kelu124/ultr4rick/hardware/Ultr4rick_B.png

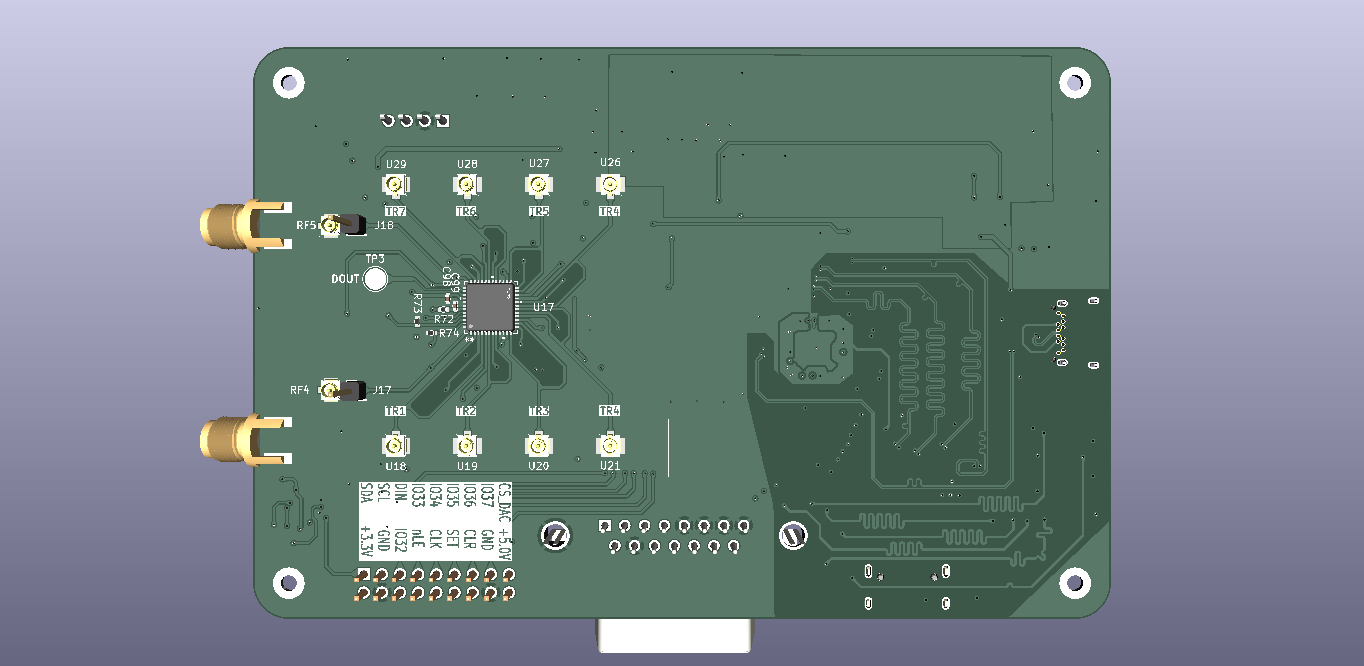
hardware/Ultr4rick_B.png
