kelu124/ultr4rick/hardware/Ultr4rick_F.png

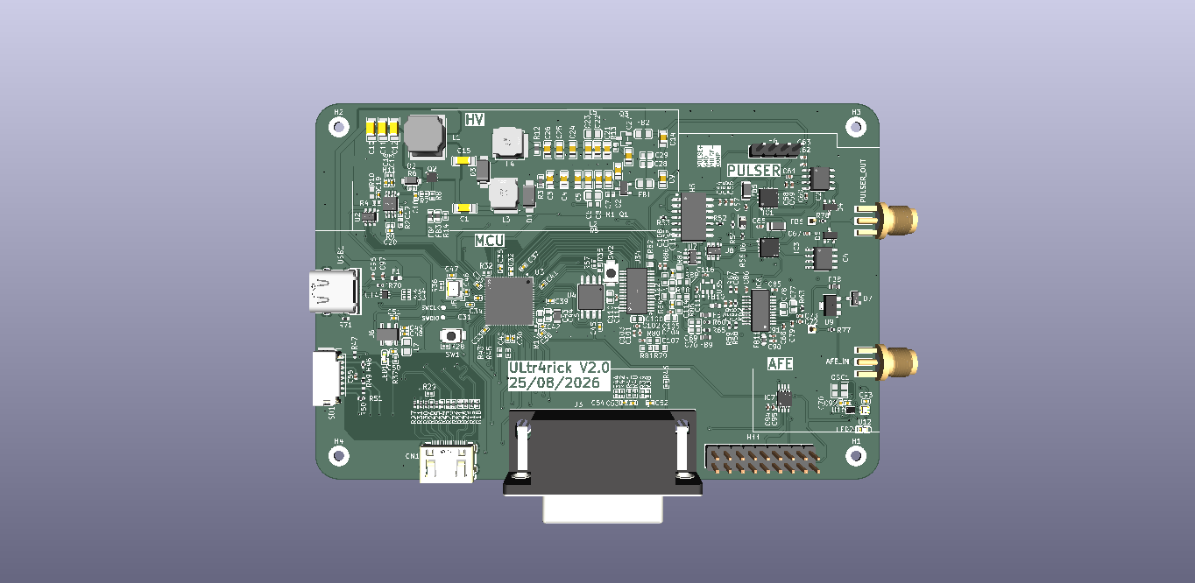
hardware/Ultr4rick_F.png
