kelu124/ultr4rick/hardware/Ultr4rick.kicad_pcb

## KiCad design hardware/Ultr4rick.kicad_pcb (2026-10-14)

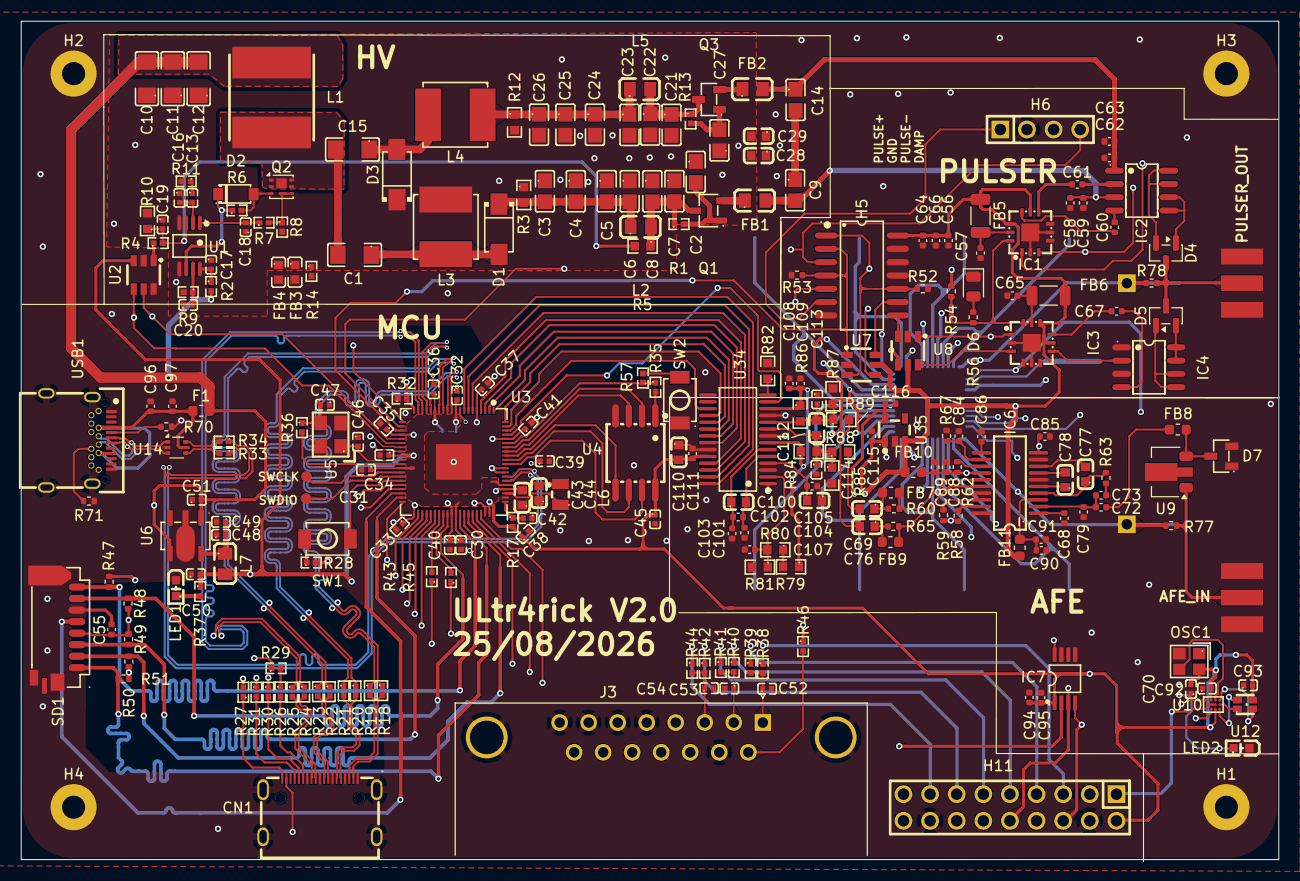
[picture p8: board Ultr4rick.kicad_pcb from above]

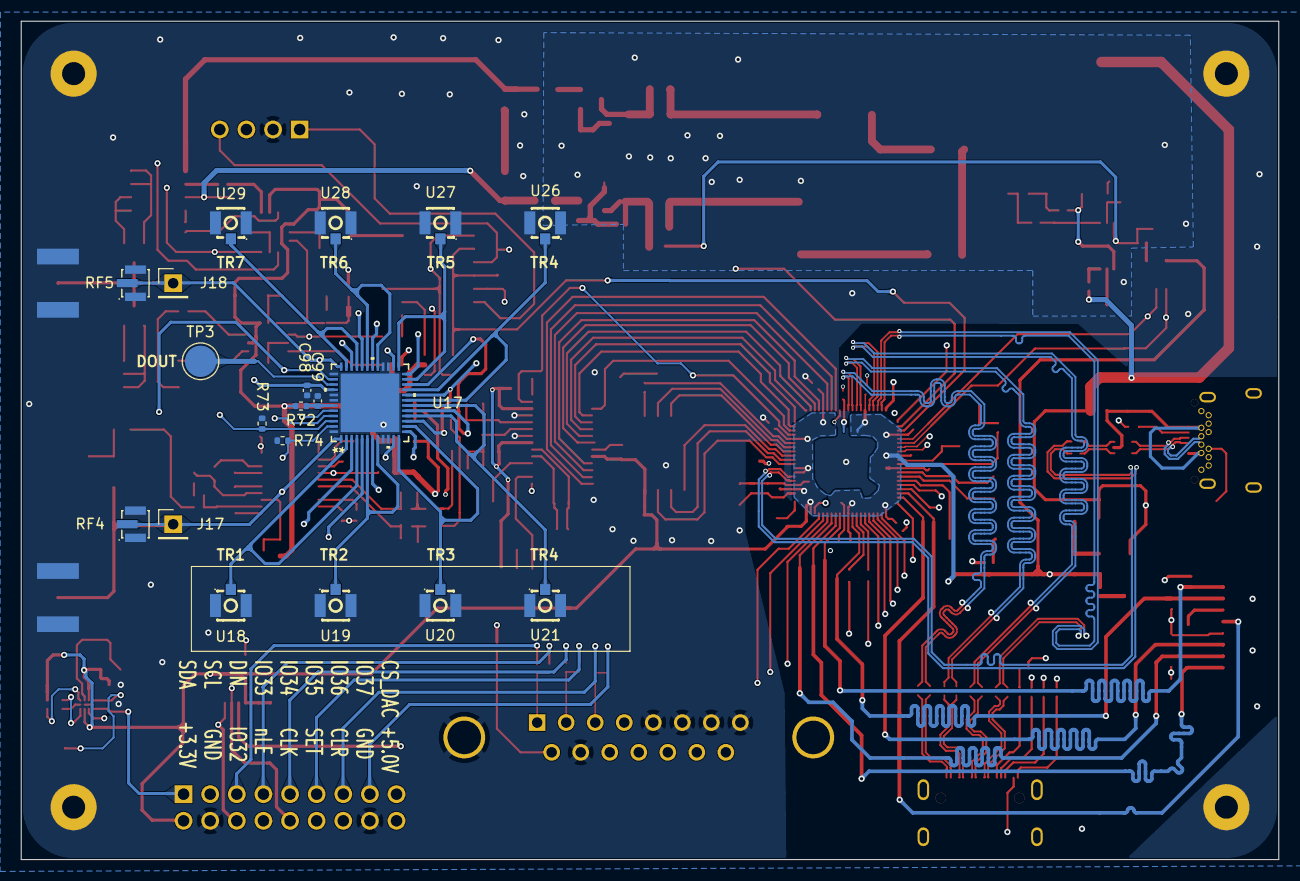
[picture p9: board Ultr4rick.kicad_pcb from below]

Board: 4 copper layers, 120.0 x 80.0 mm, 269 parts (19 on the bottom side), 198 nets.

Parts:
C1, C15: 2.2uF; C1206
C2, C3, C4, C5, C6, C7, C8, C21, C22, C23, C24, C25, C26, C27: 2.2uF; C0805
C9, C14: 100nF; C0805
C10, C11: 47uF; C1206
C12: 100nF; C1206
C13, C16, C30, C31, C33, C34, C35, C36, C37, C38, C39, C40, C41, C45, C49: 100nF; C0402
C17, C32, C42, C48: 4.7uF; C0402
C18: 2200pF; C0402
C19, C20: 100pF; C0402
C28, C29: 100nF; C0603
C43, C44: 4.7uF; C0603
C46, C47: 15pF; C0402
C50, C51: 10uF; C0402
C52, C53, C54: 220nF; C0402
C55, C94: 10uF; C_0402_1005Metric
C56, C57, C59, C63, C64, C65, C66, C68, C84, C86, C89, C91, C95, C99, C101, C102, C103, C105, C107, C109, C111: 100nF; C_0402_1005Metric
C58, C62, C98: 1uF; C_0402_1005Metric
C60, C61, C67, C72: 10nF; C_0402_1005Metric
C69, C76, C77, C78: 10nF; C0603
C70: 10nF; C0402
C73: 18nF; C_0402_1005Metric
C79: 22pF; C_0402_1005Metric
C85, C88, C90: 1nF; C_0402_1005Metric
C92, C93: 4u7; C0402
C96, C97: 4u7; C_0402_1005Metric
C100, C104, C110: 10uF; C0603
C108, C115, C116: 4.7uF; C_0402_1005Metric
C112: 100pF; C0603
C113, C114: 22pF; C0402
CN1: A71-05H4-111N1; HDMI-SMD_A71-05H4-111N1
D1, D3: SS320_C18199172; SMA_L4.3-W2.6-LS5.0-RD
D2: 1N4148W T4; SOD-123_L2.8-W1.8-LS3.7-RD
D4, D5: BAV99; SOT-23
D6: Green LED; D_0805_2012Metric
D7: BAV99-7-F; SOT-23-3_L2.9-W1.3-P1.90-LS2.4-BR
F1: 1A; Fuse_0603_1608Metric
FB1, FB2: 1.2Ω; L0805
FB3, FB4: 8.5Ω; L0603
FB5, FB6: 120Ohm 3 A; L_1206_3216Metric
FB7, FB8, FB9, FB10, FB11: L_0603_1608Metric
H1, H2, H3, H4: MountingHole_Pad; MountingHole_2.2mm_M2_Pad
H5: TC74VHC08F_EL,K,F_; SOP-14_L10.2-W5.3-P1.27-LS7.8-BL
H6: Header-Male-2.54_1x4; HDR-TH_4P-P2.54-V-M
H11: HX PZ2.54-2X9P ZZ; HDR-TH_18P-P2.54-V-M-R2-C9-S2.54-1
IC1, IC3: MD1213K6-G; QFN-12_L4.0-W4.0-P0.80-BL-EP1.7
IC2, IC4: TC6320TG-G; SOIC-8_L4.9-W3.9-P1.27-LS6.0-BL
IC6: AD8331ARQZ; QSOP-20_L8.7-W3.9-P0.64-LS6.0-BL
IC7: MCP4812-E_MS; MSOP-8_L3.0-W3.0-P0.65-LS4.9-BL
J1, J2: SMA_Edge; SMA_Edge_8mm
J3: DE15_Socket_HighDensity_MountingHoles; DSUB-15_Socket_Horizontal_P2.77x2.84mm_EdgePinOffset9.90mm_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
J17, J18: Conn_01x01_Pin; PinHeader_1x01_P2.54mm_Vertical
L1: 100uH; IND-SMD_L8.0-W8.0
L2, L5: 10uH; L0805
L3, L4: 1mH; IND-SMD_L6.0-W6.0_SWPA6045S
L6: 3.3uH; IND-SMD_L2.0-W1.6_AOTA-B201610S3R3-101-T
L7: MH2029-601Y; L0805
LED1, LED2: KT-0603R; LED-SMD_L1.6-W0.8-R-RD
NT1: NetTie_2; NetTie-2_SMD_Pad0.5mm
OSC1: SX2M32.768KM20F30TNN; OSC-SMD_4P-L2.5-W2.0-BL
Q1: FMMT495TA; SOT-23-3_L2.9-W1.6-P1.90-LS2.8-BR
Q2: CSD19538Q2; Texas_DQK
Q3: FMMT596TA; SOT-23-3_L2.9-W1.3-P1.90-LS2.4-BR
R1, R13: 10k; R0402
R2, R33, R34: 22Ω; R0402
R3, R12: 100k; R0603
R4: 56k; R0402
R5: 330k; R0603
R6: 1Ω; R0402
R7, R43, R45, R46: 100Ω; R0402
R8: 0.1Ω; R0402
R9: 40.2k; R0402
R10: 5.1k; R0603
R11: 4.7k; R0402
R14, R35: 0Ω; R0402
R17: 33Ω; R0402
R18, R19, R20, R21, R22, R23, R24, R25, R26: 200Ω; R0402
R27: 1.8kΩ; R0402
R28, R36, R57: 1kΩ; R0402
R29, R30, R31: 2.2kΩ; R0402
R32: 3.3kΩ; R0402
R37: 330Ω; R0402
R38, R40, R42: 510Ω; R0402
R39, R41, R44: 1KΩ; R0402
R47, R48, R49, R50, R51, R52, R53, R54, R58, R59, R62, R73, R74: 10K; R_0402_1005Metric
R56: 1K; R_0402_1005Metric
R60, R65: 100R; R_0402_1005Metric
R63: 280R; R_0402_1005Metric
R67: 12K; R_0402_1005Metric
R70, R71: 5K1; R_0402_1005Metric
R72: 10R; R_0402_1005Metric
R77, R78: 0Ω; R_0402_1005Metric
R79, R80, R81, R82, R84, R85, R86, R87: 1k; R0603
R88, R89: 18R; R0603
RF4, RF5: CONUFL001-SMD-T; IPEX-SMD_3P-L2.6-W2.6-LS3.0
SD1: TF-027-H300; TF-SMD_HYCW104-TF08-375B
SW1, SW2: TS-1088-AR02016; SW-SMD_L3.9-W3.0-P4.45
TP1, TP2: 1.0mm; TestPoint-1.0mm
TP3: TestPoint; TestPoint_Pad_D3.0mm
U1: LM3488MMX/NOPB; VSSOP-8_L3.0-W3.0-P0.65-LS4.9-BL
U2: MCP4725A1T-E/CH; SOT-23-6_L2.9-W1.6-P0.95-LS2.8-BR
U3: RP2350B; QFN-80_L10.0-W10.0-P0.40-TL-EP3.4
U4: W25Q128JVSIM; SOIC-8_L5.2-W5.2-P1.27-LS7.9-BL
U5: 12MHz; OSC-SMD_4P-L3.2-W2.5-BL_SIT8008BI
U6: XC6220B331PR-G; SOT-89-5_L4.5-W2.5-P1.50-LS4.4-BR
U7, U8: SN74LVC2G04DBVT; SOT-23-6_L2.9-W1.6-P0.95-LS2.8-BR
U9: MD0100N8-G; SOT-89-3
U10: LP5562TMX/NOPB; DSBGA-12_L1.7-W1.3-R3-C4-P0.40-TL
U12: A-SP1943B1GHR6C-C01-2T; LED-SMD_4P-L1.6-W1.5-BL_A-SP1943B1GHR6C-C01-2T
U14: USBLC6-2P6; SOT-666
U17: MAX14866UTM+T; 21-0144H_T4877-6_MXM
U18, U19, U20, U21, U26, U27, U28, U29: BWU.FL-IPEX1; IPEX-SMD_BWIPX-1-001E
U34: AD9215BRUZRL7-65; TSSOP-28_L9.7-W4.4-P0.65-LS6.4-BL
U35: XC6210B302MR; SOT-23-5_L2.9-W1.6-P0.95-LS2.8-BR
USB1: TYPEC-503DSL-ACP24; USB-C-SMD_TYPEC-324-BCP24

Connections:
5VLNA: C90.1, C91.1, FB11.2, IC6.3 (VPSL)
5VVGA: C88.1, C89.1, FB10.1, IC6.14 (VPOS), R58.1, R59.1, R62.1
+1.1V: C30.1, C31.1, C32.2, C44.2, L6.2, U3.10 (DVDD), U3.32 (DVDD), U3.51 (DVDD), U3.65 (VREG_FB)
+3.3V: C33.1, C34.1, C35.1, C36.1, C37.1, C38.1, C39.1, C40.1, C41.1, C43.2, C45.1, C50.2, C55.2, C70.2, C92.2, C93.2, C94.1, C95.1, C98.2, C110.2, C111.1, H11.2, IC7.1 (VDD), L7.2, OSC1.4 (VDD), R17.2, R37.1, R47.1, R48.1, R49.1, R50.1, R51.1, R54.1, SD1.4 (VDD), U2.3 (VDD), U3.5 (IOVDD), U3.15 (IOVDD), U3.24 (IOVDD), U3.29 (IOVDD), U3.41 (IOVDD), U3.50 (IOVDD), U3.59 (ADC_AVDD), U3.60 (IOVDD), U3.64 (VREG_VIN), U3.68 (USB_OTP_VDD), U3.69 (QSPI_IOVDD), U3.76 (IOVDD), U4.8 (VCC), U10.A2 (VDD), U10.C3 (EN/VCC), U12.3, U17.40 (VDD), U34.24 (DRVDD)
+5V: C10.2, C11.2, C12.2, C51.2, C56.1, C64.1, C66.1, C115.1, CN1.18 (+5V), F1.2, FB5.1, FB6.1, FB10.2, FB11.1, H5.14 (VCC), H11.18, IC1.8 (VH), IC1.10 (VDD2), IC3.8 (VH), IC3.10 (VDD2), L1.1 (+), R2.2, R46.1, R72.2, U6.1 (CE), U6.4 (VIN), U7.5 (VCC), U8.5 (VCC), U35.1 (VIN), U35.3 (CE)
+HV: C9.2, C58.2, C59.2, FB1.2, IC2.3 (SP)
-HV: C14.1, C62.2, C63.2, FB2.2, IC2.1 (SN)
/DAC+AFE/ECHO_IN: J2.1 (In), R77.2, U9.1 (A)
/MUX/DOUT: TP3.1 (1_1), U17.39 (DOUT)
/MUX/MUX_IN: J17.1 (Pin_1_1), R77.1, RF4.1, U17.1 (COM0), U17.5 (COM2), U17.11 (COM4), U17.15 (COM6), U17.20 (COM8), U17.24 (COM10), U17.30 (COM12), U17.34 (COM14)
/MUX/MUX_OUT: J18.1 (Pin_1_1), R78.1, RF5.1, U17.3 (COM1), U17.7 (COM3), U17.13 (COM5), U17.17 (COM7), U17.22 (COM9), U17.26 (COM11), U17.32 (COM13), U17.36 (COM15)
/MUX/NO0: U17.2 (NO0), U17.4 (NO1), U18.1
/MUX/NO2: U17.6 (NO2), U17.8 (NO3), U19.1
/MUX/NO4: U17.12 (NO4), U17.14 (NO5), U20.1
/MUX/NO6: U17.16 (NO6), U17.18 (NO7), U21.1
/MUX/NO8: U17.19 (NO8), U17.21 (NO9), U26.1
/MUX/NO10: U17.23 (NO10), U17.25 (NO11), U27.1
/MUX/NO12: U17.29 (NO12), U17.31 (NO13), U28.1
/MUX/NO14: U17.33 (NO14), U17.35 (NO15), U29.1
/MUX/TX: D4.3 (K), D5.3 (K), J1.1 (In), R78.2
/RP2350B/BLUE: C54.1, J3.3, R42.2, R44.2
/RP2350B/BOOT: SW1.1, U3.35 (RUN)
/RP2350B/GREEN: C53.1, J3.2, R40.2, R41.2
/RP2350B/HDMI_CLK_N: CN1.12 (TMDS_CLOCK-), R25.2
/RP2350B/HDMI_CLK_P: CN1.11 (TMDS_CLOCK+), R24.2
/RP2350B/HDMI_D0_N: CN1.9 (TMDS_DATA0-), R23.2
/RP2350B/HDMI_D0_P: CN1.8 (TMDS_DATA0+), R22.2
/RP2350B/HDMI_D1_N: CN1.6 (TMDS_DATA1-), R21.2
/RP2350B/HDMI_D1_P: CN1.5 (TMDS_DATA1+), R20.2
/RP2350B/HDMI_D2_N: CN1.3 (TMDS_DATA2-), R19.2
/RP2350B/HDMI_D2_P: CN1.2 (TMDS_DATA2+), R18.2
/RP2350B/RED: C52.1, J3.1, R38.2, R39.2
/RP2350B/SWCLK: TP1.1 (1_1), U3.33 (SWCLK)
/RP2350B/SWDIO: TP2.1 (1_1), U3.34 (SWDIO)
/RP2350B/USB_DN: R33.1, U3.66 (USB_DM)
/RP2350B/USB_DP: R34.1, U3.67 (USB_DP)
/SEPIC_HV/Vfb: C19.2, R4.2, R5.2, R10.1, U1.3 (FB)
/USB3/USB_DDN: R33.2, U14.4 (IO2)
/USB3/USB_DDP: R34.2, U14.6 (IO1)
/USB3/VBUS: C96.2, C97.1, F1.1, U14.5 (VBUS), USB1.A4 (VBUS), USB1.A9 (VBUS), USB1.B4 (VBUS), USB1.B9 (VBUS)
ADC_0: U3.78 (GPIO1), U34.17 (D0(LSB))
ADC_1: U3.79 (GPIO2), U34.18 (D1)
ADC_2: U3.80 (GPIO3), U34.19 (D2)
ADC_3: U3.1 (GPIO4), U34.20 (D3)
ADC_4: U3.2 (GPIO5), U34.21 (D4)
ADC_5: U3.3 (GPIO6), U34.22 (D5)
ADC_6: U3.4 (GPIO7), U34.25 (D6)
ADC_7: U3.6 (GPIO8), U34.26 (D7)
ADC_8: U3.7 (GPIO9), U34.27 (D8)
ADC_9: U3.8 (GPIO10), U34.28 (D9(MSB))
ADC_CLK: U3.77 (GPIO0), U34.13 (CLK)
AVDD: C108.1, C109.1, C116.1, R79.1, R84.1, R86.1, U34.7 (AVDD), U34.12 (AVDD), U35.5 (OUT)
AVSS: C9.1, C14.2
B: U10.A4 (B), U12.4
CLK: H11.10, IC7.3 (SCK), U3.27 (GPIO26), U17.45 (CLK)
CLK_N: R25.1, U3.19 (GPIO19)
CLK_P: R24.1, U3.18 (GPIO18)
CLR: H11.14, R74.1, U3.37 (GPIO29), U17.47 (CLR)
CS_DAC: H11.17, IC7.2 (~CS), U3.9 (GPIO11)
DAC_G: C85.1, IC6.10 (GAIN), IC7.8 (VOUTA)
DAMP: H5.3 (1Y), H6.4, IC3.1 (INA), U8.1 (1A)
DIN: H11.6, IC7.4 (SDI), U3.28 (GPIO27), U17.44 (DIN)
DVI_CEC: R29.1, U3.57 (GPIO46_ADC6)
DVI_D0_N: R23.1, U3.17 (GPIO17)
DVI_D0_P: R22.1, U3.16 (GPIO16)
DVI_D1_N: R21.1, U3.14 (GPIO15)
DVI_D1_P: R20.1, U3.13 (GPIO14)
DVI_D2_N: R19.1, U3.12 (GPIO13)
DVI_D2_P: R18.1, U3.11 (GPIO12)
DVI_SCL: R30.1, U3.56 (GPIO45_ADC5)
DVI_SDA: R31.1, U3.55 (GPIO44_ADC4)
G: U10.B4 (G), U12.1
GND: C28.1, C29.1, C30.2, C31.2, C32.1, C33.2, C34.2, C35.2, C36.2, C37.2, C38.2, C39.2, C40.2, C41.2, C42.1, C43.1, C44.1, C45.2, C46.1, C47.1, C48.1, C49.2, C50.1, C51.1, C52.2, C53.2, C54.2, C55.1, C56.2, C57.1, C58.1, C59.1, C62.1, C63.1, C64.2, C65.1, C66.2, C68.1, C70.1, C79.2, C84.2, C85.2, C86.2, C88.2, C89.2, C90.2, C91.2, C92.1, C93.1, C94.2, C95.2, C96.1, C97.2, C98.1, C99.1, C101.1, C103.1, C104.1, C105.2, C107.2, C108.2, C109.2, C110.1, C111.2, C113.1, C114.2, C115.2, C116.2, CN1.1 (TMDS_DATA2_SHIELD), CN1.4 (TMDS_DATA1_SHIELD), CN1.7 (TMDS_DATA0_SHIELD), CN1.10 (TMDS_CLOCK_SHIELD), CN1.13 (DDC/CEC_GND), CN1.20 (SHELL), CN1.21 (SHELL), CN1.22 (SHELL), CN1.23 (SHELL), D6.1, D7.1, D7.2, FB3.2, FB4.2, H1.1 (1_1), H2.1 (1_1), H3.1 (1_1), H4.1 (1_1), H5.7 (GND), H5.11 (4Y), H5.12 (4A), H5.13 (4B), H6.2, H11.4, H11.16, IC1.2 (VL), IC1.4 (GND_1), IC1.5 (VSS1), IC1.6 (VSS2), IC1.13 (GND_2), IC3.2 (VL), IC3.4 (GND_1), IC3.5 (VSS1), IC3.6 (VSS2), IC3.13 (GND_2), IC4.1 (SN), IC4.3 (SP), IC6.6 (COML), IC6.9 (MODE), IC6.17 (COMM_1), IC6.20 (COMM_2), IC7.5 (~LDAC), IC7.7 (VSS), J1.2 (Ext), J2.2 (Ext), J3.5, J3.6, J3.7, J3.8, J3.10, J3.SH, LED1.2 (K), LED2.2 (K), OSC1.2 (GND), R14.2, R28.2, R32.1, R52.2, R53.2, R67.2, R70.1, R71.2, R73.2, R74.2, R81.2, R82.2, R85.2, R87.2, RF4.2, RF4.3, RF5.2, RF5.3, SD1.6 (VSS), SD1.10, SD1.11, SW2.2, U2.2 (VSS), U2.6 (A0), U3.62 (VREG_PGND), U3.81 (GND), U4.4 (GND), U5.2 (GND), U5.4 (GND), U6.2 (VSS), U7.2 (GND), U8.2 (GND), U10.B1 (ADDR_SEL1), U10.B2 (ADDR_SEL0), U10.B3 (GND), U14.2 (GND), U17.9 (GND), U17.10 (GND), U17.27 (GND), U17.28 (GND), U17.37 (GND), U17.41 (GND), U17.42 (GND), U17.48 (GND), U17.49 (EPAD), U18.2, U18.3, U19.2, U19.3, U20.2, U20.3, U21.2, U21.3, U26.2, U26.3, U27.2, U27.3, U28.2, U28.3, U29.2, U29.3, U34.3 (SENSE), U34.8 (AGND), U34.11 (AGND), U34.23 (DRGND), U35.2 (GND), USB1.1 (EH), USB1.2 (EH), USB1.3 (EH), USB1.4 (EH), USB1.A1 (GND), USB1.A12 (GND), USB1.B1 (GND), USB1.B12 (GND)
GPIO20: R27.2, R32.2, U3.20 (GPIO20)
GPIO32: H11.5, R38.1, U3.40 (GPIO32)
GPIO33: H11.7, R39.1, U3.42 (GPIO33)
GPIO34: H11.9, R40.1, U3.43 (GPIO34)
GPIO35: H11.11, R41.1, U3.44 (GPIO35)
GPIO36: H11.13, R42.1, U3.45 (GPIO36)
GPIO37: H11.15, R44.1, U3.46 (GPIO37)
GPIO38: R43.2, U3.47 (GPIO38)
GPIO39: R45.2, U3.48 (GPIO39)
HVGND: C2.1, C3.1, C4.1, C5.1, C6.1, C7.1, C8.1, C10.1, C11.1, C12.1, C16.1, C17.1, C18.1, C19.1, C20.1, C21.2, C22.2, C23.2, C24.2, C25.2, C26.2, C27.1, C28.2, C29.2, D3.1 (K), FB3.1, FB4.1, L3.1 (+), R3.1, R8.2, R9.2, R10.2, R11.2, R12.2, R14.1, U1.4 (AGND), U1.5 (PGND)
I2C0_SCL: H11.3, U2.4 (SDA), U3.26 (GPIO25), U10.C2 (SCL)
I2C0_SDA: H11.1, U2.5 (SCL), U3.25 (GPIO24), U10.C1 (SDA)
INPUT_A: H5.1 (1A), H5.10 (3B), R52.1, U3.22 (GPIO22), U7.3 (2A)
INPUT_B: H5.2 (1B), H5.4 (2A), R53.1, U3.23 (GPIO23), U7.1 (1A)
unnamed: C13.1, R11.1
unnamed: C47.2, R36.1, U5.3
unnamed: C69.1, FB7.2, R60.2
unnamed: C72.1, FB8.2
unnamed: C73.2, R63.1
unnamed: C76.1, FB9.2, R65.2
unnamed: CN1.14 (CEC), R26.2
unnamed: CN1.19 (HP_DETECT), R27.1
unnamed: CN1.15 (SCL), R30.2
unnamed: CN1.16 (SDA), R31.2
unnamed: C1.1, D1.2 (A), L3.2 (-)
unnamed: C3.2, C4.2, C5.2, C6.2, D1.1 (K), L2.1 (+), R3.2
unnamed: D2.2 (A), Q2.3 (G), R6.2
unnamed: D2.1 (K), R6.1, U1.6 (DR)
unnamed: C15.1, D3.2 (A), L4.2 (-)
unnamed: D4.2 (A), IC2.7 (DN_1), IC2.8 (DN_2)
unnamed: D5.2 (A), IC4.7 (DN_1), IC4.8 (DN_2)
unnamed: D6.2, R56.2
unnamed: H5.5 (2B), U7.4 (2Y)
unnamed: H5.9 (3A), U7.6 (1Y)
unnamed: H5.8 (3Y), U8.3 (2A)
unnamed: C60.1, IC1.9 (OUTA)
unnamed: C61.1, IC1.7 (OUTB)
unnamed: C57.2, FB5.2, IC1.11 (VDD1)
unnamed: D4.1 (K), IC2.5 (DP_1), IC2.6 (DP_2)
unnamed: C61.2, IC2.2 (GN)
unnamed: C60.2, IC2.4 (GP)
unnamed: C67.1, IC3.9 (OUTA)
unnamed: IC3.7 (OUTB), IC4.2 (GN)
unnamed: C65.2, FB6.2, IC3.11 (VDD1)
unnamed: D5.1 (K), IC4.5 (DP_1), IC4.6 (DP_2)
unnamed: C67.2, IC4.4 (GP)
unnamed: IC6.19 (ENBL), R58.2
unnamed: IC6.18 (ENBV), R59.2
unnamed: IC6.13 (HILO), R62.2
unnamed: C72.2, C73.1, C79.1, IC6.2 (INH)
unnamed: C68.2, IC6.1 (LMD)
unnamed: C77.1, IC6.4 (LON), R63.2
unnamed: C78.1, IC6.5 (LOP)
unnamed: C84.1, IC6.12 (RCLMP), R67.1
unnamed: C86.1, IC6.11 (VCM)
unnamed: C77.2, IC6.8 (VIN)
unnamed: C78.2, IC6.7 (VIP)
unnamed: J3.9, R46.2
unnamed: J3.13, R43.1
unnamed: J3.14, R45.1
unnamed: C1.2, C15.2, L1.2 (-), Q2.1 (D), Q2.2 (D), Q2.5 (D), Q2.6 (D), Q2.8 (D)
unnamed: C7.2, C8.2, L2.2 (-), Q1.3 (C), R1.1, R5.1
unnamed: C23.1, C24.1, C25.1, C26.1, L4.1 (+), L5.1 (+), R12.1
unnamed: C21.1, C22.1, L5.2 (-), Q3.3 (C), R13.1
unnamed: LED1.1 (A), R37.2
unnamed: LED2.1 (A), U10.A1 (W)
unnamed: OSC1.3 (OUTPUT), U10.A3 (CLK_32K)
unnamed: C2.2, Q1.1 (B), R1.2
unnamed: FB1.1, Q1.2 (E)
unnamed: Q2.4 (S), Q2.7 (S), R7.2, R8.1
unnamed: C27.2, Q3.1 (B), R13.2
unnamed: FB2.1, Q3.2 (E)
unnamed: R26.1, R29.2
unnamed: R28.1, SW1.2
unnamed: R57.2, SW2.1
unnamed: R79.2, R80.1
unnamed: C13.2, C16.2, U1.2 (COMP)
unnamed: C20.2, R9.1, U1.7 (FA)
unnamed: C18.2, R7.1, U1.1 (ISEN)
unnamed: C17.2, R2.1, U1.8 (VIN)
unnamed: C42.2, R17.1, U3.61 (VREG_AVDD)
unnamed: L6.1, U3.63 (VREG_LX)
unnamed: R35.2, U4.1 (/CS)
unnamed: C48.2, C49.1, L7.1, U6.5 (VOUT)
unnamed: D7.3, FB8.1, U9.3 (B)
unnamed: C99.2, R72.1, U17.43 (VCC)
unnamed: C107.1, R80.2, R81.1, U34.2 (MODE)
unnamed: R82.1, U34.14 (PDWN)
unnamed: C100.2, C101.2, C102.1, U34.5 (REFB)
unnamed: C100.1, C102.2, C103.2, U34.6 (REFT)
unnamed: C112.1, C114.1, R84.2, R85.1, R88.1, U34.9 (VIN+)
unnamed: C112.2, C113.2, R86.2, R87.1, R89.1, U34.10 (VIN–)
unnamed: C104.2, C105.1, U34.4 (VREF)
unnamed: R70.2, USB1.A5 (CC1)
unnamed: R71.1, USB1.B5 (CC2)
OE: IC1.12 (OE), IC3.12 (OE), NT1.2, R56.1
OE_HV: NT1.1, R54.2
OR: U3.58 (GPIO47_ADC7), U34.1 (OR)
PULSE+: H5.6 (2Y), H6.1, IC1.1 (INA)
PULSE-: H6.3, IC1.3 (INB), U8.4 (2Y)
QSPI_SCLK: U3.71 (QSPI_SCLK), U4.6 (CLK)
QSPI_SD0: U3.72 (QSPI_SD0), U4.5 (DI(IO0))
QSPI_SD1: U3.74 (QSPI_SD1), U4.2 (DO(IO1))
QSPI_SD2: U3.73 (QSPI_SD2), U4.3 (/WP(IO2))
QSPI_SD3: U3.70 (QSPI_SD3), U4.7 (/HOLDor/RESET(IO3))
QSPI_SS: R35.1, R57.1, U3.75 (QSPI_SS)
R: U10.C4 (R), U12.2
SD_CMD: R49.2, SD1.3 (CMD), U3.39 (GPIO31)
SD_D0: R48.2, SD1.7 (DAT0), U3.49 (GPIO40_ADC0)
SD_D1: R47.2, SD1.8 (DAT1), U3.52 (GPIO41_ADC1)
SD_D2: R51.2, SD1.1 (DAT2), U3.53 (GPIO42_ADC2)
SD_D3: R50.2, SD1.2 (CD/DAT3), U3.54 (GPIO43_ADC3)
SD_SCK: SD1.5 (CLK), U3.38 (GPIO30)
SET: H11.12, R73.1, U3.36 (GPIO28), U17.46 (SET)
TO_ADC_H: C69.2, R88.2
TO_ADC_L: C76.2, R89.2
UD+: U14.1 (IO1), USB1.A6 (DP1), USB1.B6 (DP2)
UD-: U14.3 (IO2), USB1.A7 (DN1), USB1.B7 (DN2)
VOH: FB7.1, IC6.15 (VOH), R60.1
VOL: FB9.1, IC6.16 (VOL), R65.1
Vadj: R4.1, U2.1 (VOUT)
XIN: C46.2, U3.30 (XIN), U5.1
XOUT: R36.2, U3.31 (XOUT)
nLE: H11.8, U3.21 (GPIO21), U17.38 (*LE)
~DAMP: IC3.3 (INB), U8.6 (1Y)
