kelu124/ultr4rick/firmware/hw/u4rk.h

// SPDX-License-Identifier: GPL-3.0-or-later
#ifndef U4RK_H
#define U4RK_H

#include <stdbool.h>
#include <stddef.h>
#include <stdint.h>

/* Sample counts are mode-dependent, not build-dependent:
 *   - FFT/envelope path (read_fft) is fixed at 4096, the max power-of-two the
 *     CMSIS arm_rfft_fast_f32 supports.
 *   - Raw path (read_raw) captures 8000 (matches the historical mainline depth).
 * Buffers are sized to U4RK_MAX_SAMPLE_COUNT. */
#define U4RK_SAMPLE_COUNT             4096u   /* FFT/envelope length */
#define U4RK_RAW_SAMPLE_COUNT         8000u   /* raw-only length */
#define U4RK_MAX_SAMPLE_COUNT         U4RK_RAW_SAMPLE_COUNT
#define U4RK_SAMPLE_RATE_HZ           60000000u
#define U4RK_PROTOCOL_VERSION         1u
#define U4RK_HEADER_SIZE              64u
/* Largest payload across modes: 4096 floats (16384 B) > 8000 u16 (16000 B). */
#define U4RK_MAX_PAYLOAD_SIZE         (U4RK_SAMPLE_COUNT * sizeof(float))
#define U4RK_MAX_FRAME_SIZE           (U4RK_HEADER_SIZE + U4RK_MAX_PAYLOAD_SIZE)
#define U4RK_RAW_BUFFER_COUNT         2u
#define U4RK_OUTPUT_SLOT_COUNT        2u
#define U4RK_ALAW_DEFAULT_REFERENCE   512.0f
#define U4RK_RAW_MAX_RATE_HZ          100u
#define U4RK_ENVELOPE_MAX_RATE_HZ     50u
#define U4RK_ALAW_MAX_RATE_HZ         70u
#define U4RK_DSP_TARGET_US            4500u

/* Pin map: Ultr4rick v2 (hardware/) on RP2350B. See PINMAP.md. */
#define U4RK_ADC_CLOCK_PIN            0u
#define U4RK_ADC_DATA_FIRST_PIN       1u
#define U4RK_ADC_DATA_PIN_COUNT       10u

/* Pulser A/B on consecutive pins (A = bit 0, B = bit 1):
 *   B A = 0 0 all low, 0 1 negative, 1 1 damping, 1 0 positive. */
#define U4RK_PULSER_PIN_BASE          22u
#define U4RK_PULSER_A_PIN             22u
#define U4RK_PULSER_B_PIN             23u
#define U4RK_PULSER_STATE_OFF         0u
#define U4RK_PULSER_STATE_NEGATIVE    1u
#define U4RK_PULSER_STATE_POSITIVE    2u
#define U4RK_PULSER_STATE_DAMP        3u

/* SPI1 bus shared by the MCP4812 (CS_DAC) and MAX14866 (nLE). */
#define U4RK_SPI_SCK_PIN              26u
#define U4RK_SPI_TX_PIN               27u
#define U4RK_DAC_CS_PIN               11u

#define U4RK_MUX_LE_PIN               21u
#define U4RK_MUX_SET_PIN              28u
#define U4RK_MUX_CLR_PIN              29u

/* I2C0: LP5562 RGB status LED (hw/led.c), MCP4725 (unused). */
#define U4RK_I2C_SDA_PIN              24u
#define U4RK_I2C_SCL_PIN              25u
#define U4RK_LED_LEVEL_PERCENT        5u    /* status LED brightness, % of full PWM */

/* uSD (4-bit SDIO): D0..D3 consecutive. Not driven by the firmware yet. */
#define U4RK_SD_SCK_PIN               30u
#define U4RK_SD_CMD_PIN               31u
#define U4RK_SD_D0_PIN                40u
#define U4RK_SD_DATA_PIN_COUNT        4u

typedef enum {
    U4RK_PAYLOAD_NONE = 0,
    U4RK_PAYLOAD_RAW = 1,
    U4RK_PAYLOAD_ENVELOPE = 2,
    U4RK_PAYLOAD_ALAW = 3,
} u4rk_payload_type_t;

enum {
    U4RK_FLAG_ALAW_SATURATED = 1u << 0,
    U4RK_FLAG_PROCESSING_DROP = 1u << 1,
    U4RK_FLAG_USB_DROP = 1u << 2,
    U4RK_FLAG_SELFTEST = 1u << 3,
    U4RK_FLAG_PULSER_ARMED = 1u << 4,
    U4RK_FLAG_SELFTEST_CASE_SHIFT = 8,
};

typedef enum {
    U4RK_PULSE_NEGATIVE_FIRST = 0,
    U4RK_PULSE_POSITIVE_FIRST = 1,
} u4rk_pulse_order_t;

typedef struct {
    uint32_t negative_ns;
    uint32_t damp_ns;
    uint32_t positive_ns;
    u4rk_pulse_order_t order;
} u4rk_pulse_config_t;

typedef struct {
    uint8_t raw_index;
    uint8_t payload_type;
    uint16_t flags;
    uint32_t sequence;
    /* Internal USB-session tag; it is not serialized in the wire header. */
    uint32_t session_id;
    uint32_t sample_count;   /* captured length: 8000 raw, 4096 fft/envelope */
    uint32_t sample_rate_hz;
    uint64_t capture_timestamp_us;
    float alaw_reference;
    u4rk_pulse_config_t pulse;
} u4rk_capture_job_t;

typedef struct {
    uint32_t preprocess_us;
    uint32_t forward_fft_us;
    uint32_t mask_us;
    uint32_t inverse_fft_us;
    uint32_t magnitude_us;
    uint32_t alaw_us;
    uint32_t total_us;
    uint32_t worst_total_us;
    float dc_mean;
    float envelope_peak;
} u4rk_dsp_metrics_t;

#endif
