kelu124/ultr4rick/firmware/max/max14866.h

// SPDX-License-Identifier: GPL-3.0-or-later
//!
//! \file       max14866.h
//! \author     Abdelrahman Ali
//! \date       2025-01-06
//!
//! \brief      max14866 HV mux on the shared SPI1 bus.
//!
//! The MAX14866 is on the Ultr4rick board and shares SCK/DIN (GPIO26/27) with the
//! MCP4812 gain DAC (dac.h). Pins live in u4rk.h.
//!

#ifndef MAX14866_H
#define MAX14866_H

//---------------------------------------------------------------------------
// INCLUDES
//---------------------------------------------------------------------------

#include <stdio.h>
#include <stdlib.h>
#include "pico/stdlib.h"
#include "hardware/gpio.h"
#include "hardware/clocks.h"

//---------------------------------------------------------------------------
// MAX INIT FUNCTION
//---------------------------------------------------------------------------
void max14866_init();

//---------------------------------------------------------------------------
// MAX WRITE FUNCTION
//---------------------------------------------------------------------------
void max14866_write(uint16_t data);

//---------------------------------------------------------------------------
// MAX SET FUNCTION
//---------------------------------------------------------------------------
void max14866_set(const char *input);

//---------------------------------------------------------------------------
// MAX CLEAR FUNCTION
//---------------------------------------------------------------------------
void max14866_clear(const char *input);

//---------------------------------------------------------------------------
// MAX MAIN FUNCTION
//---------------------------------------------------------------------------
void max14866(const char *input);

//---------------------------------------------------------------------------
// END OF FILE
//---------------------------------------------------------------------------

#endif
