kelu124/ultr4rick/firmware/ultr4rick/tusb_config.h

#ifndef U4RK_TUSB_CONFIG_H
#define U4RK_TUSB_CONFIG_H

#ifndef CFG_TUSB_MCU
#error CFG_TUSB_MCU must be supplied by the Pico SDK
#endif

#ifndef CFG_TUSB_OS
#define CFG_TUSB_OS OPT_OS_NONE
#endif
#ifndef CFG_TUSB_DEBUG
#define CFG_TUSB_DEBUG 0
#endif
#define CFG_TUD_ENABLED 1
#define CFG_TUD_MAX_SPEED OPT_MODE_FULL_SPEED

#define CFG_TUSB_MEM_SECTION
#define CFG_TUSB_MEM_ALIGN __attribute__((aligned(4)))

#define CFG_TUD_ENDPOINT0_SIZE 64
#define CFG_TUD_CDC 1
#define CFG_TUD_MSC 0
#define CFG_TUD_HID 0
#define CFG_TUD_MIDI 0
#define CFG_TUD_VENDOR 0

/* Larger software FIFOs keep binary frame transmission non-blocking. */
#define CFG_TUD_CDC_RX_BUFSIZE 512
#define CFG_TUD_CDC_TX_BUFSIZE 2048
#define CFG_TUD_CDC_EP_BUFSIZE 64

#endif
