kelu124/ultr4rick/(commit log)

2026-07-31 Initial todos
    [DAC+AFE.kicad_sch, MUX.kicad_sch, PMODS.kicad_sch, PULSER.kicad_sch, RP2350B.kicad_sch, SEPIC_HV.kicad_sch, USB3.kicad_sch, Ultr4rick.kicad_pcb]
2026-08-03 Fixes to DSP pipeline
    [dsp.c, main.c, tusb_config.h, u4rk.h, ultr4rick_capture.py]
2026-08-26 Update of silkscreen for MUX uFL
    [Ultr4rick.kicad_pcb]
2026-10-14 embarke: port pic0rick firmware to the RP2350B Ultr4rick v2 board
    RP2350B-only board definition (12 MHz, W25Q128, no radio). Pulser on
    GPIO22/23 A/B (00 off, A neg, B pos, AB damp) with one PIO SM. MCP4812 and
    MAX14866 share hardware SPI1 on GPIO26/27 (CS_DAC 11, nLE 21, SET 28,
    CLR 29); the mux write now shifts then latches once. Device identifies as
    Ultr4rick (USB strings, U4RK frame magic). RP2040/pico2 builds dropped.
    Adds PINMAP.md, the embarke-firmware skill, and a TODO for the MCP4725
    SDA/SCL swap in the v2 schematic. Firmware 0.1.12.
2026-10-14 python: ultr4rick host library for the embarke firmware
    Rename python/pic0rick -> python/ultr4rick (0.1.9): Ultr4rick class
    (Pic0rick alias), U4RK frames, USB-ID port detection, reboot_dfu,
    command/help, dsp scale, self-test + scipy check, streaming helpers.
    Notebooks use a local python/data/ folder; example_dsp gains an
    idle-vs-pulsed figure cell. Root requirements.txt and .gitignore.
2026-10-14 docs(claude): log 90185e6 and a63e0f7, add project skills
    Adds the Claude Code project skills (build-flash, board-test, changelog,
    embarke-firmware already in 90185e6), .claude/CHANGELOG.md and the
    per-commit notes, including the 2026-10-12 setup and ADC-baseline notes.
2026-10-14 repo: v2 hardware and RP2350B firmware become hardware/ and firmware/
    Replace hardware/ (v1) with hardware_v2/ and firmware/ (Ultr4rick 1.5,
    protocol doc, capture tool) with embarke/; both old trees stay in history
    at 4da14a5. Rename the board embarke -> ultr4rick (boards/ultr4rick.h,
    PICO_BOARD, UF2 names), fix build.sh dropping its CMake arguments, and
    make flash.sh enter BOOTSEL via reboot-dfu. Rewrite README.md, CLAUDE.md
    and the skills for the new layout; add ultr4rick-versioning, TODO/DONE
    tracking and the commit-per-step rule. Firmware 0.1.13, python 0.1.10.
    Verified: both variants build with 0 warnings; flash.sh flashed 0.1.13
    without the BOOTSEL button; self-test 7/7, 20-frame stre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
2026-10-14 firmware: LP5562 status LED (pipeline stage colours, W = port open)
    RGB on the LP5562 (I2C0, GPIO24/25, 100 kHz on internal pull-ups) shows the
    pipeline stage at 5% PWM: white boot, green idle, yellow capture, blue DSP,
    magenta USB transmit, red fault. W (LED2) is on while a host has the ttyACM
    open (CDC DTR) and off when it drops. Core 0 only, writes on change. The
    stdio REPL now polls input so the LED follows the port. status reports
    led=ok|absent. Firmware 0.1.14. Also: flash.sh no longer aborts when the
    desktop automounter wins the race; TODO notes the missing I2C pull-ups.
    Verified: led=ok (LP5562 ACK + PWM read-back), self-test 7/7, streams OK.
    DSP time moved 13.4 -> 16.8-18.7 ms; exp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
2026-10-14 firmware: run from SRAM so DSP time no longer depends on flash layout
    pico_set_binary_type(copy_to_ram). Under XIP the same DSP code took 13.4,
    16.8-18.7 or 19.9-20.3 ms depending on where code and CMSIS tables landed
    in flash. From SRAM the one-shot envelope is 6.55 ms (FFTs 2.3/2.6 ms) and
    the worst case with A-law is 7.3 ms. About 270 KB of 520 KB SRAM is used.
    Firmware 0.1.15.
    Verified: self-test 7/7, LED ok, 20 Hz envelope and 70 Hz A-law streams
    with <= 1 drop; 50 Hz envelope is now USB-bound (~25% drops).
2026-10-18 python: mux helpers write_mux(any pattern), set_one_mux(k), mux_element_mask
    write_mux() now takes any 16-bit pattern as an int or hex string, range-checks
    it and always sends 4 hex digits. set_one_mux(k) closes the RX (SW2k-2) and
    TX (SW2k-1) switches of element k = 1..8, following the U17 netlist in
    hardware/MUX.kicad_sch (even COMs -> ECHO_IN, odd COMs -> TX).
    Verified against a fake serial port (commands 0003..C000, range errors).
    Not verified on hardware: the board was not enumerated. The SWn <-> bit n
    order is not yet confirmed on the board.
    Python 0.1.10 -> 0.1.11.
2026-10-18 python: Ultr4rick() reads firmware and library versions at connection
    The constructor now sends `version` (one retry if the reply is lost or
    partial) and stores two strings: firmware_version (e.g. "0.1.15", "unknown"
    if it cannot be parsed) and library_version (ultr4rick.__version__). Both are
    printed after "Device on ..." and returned by versions().
    Verified against fake serial ports (parsed reply -> ('0.1.15', '0.1.12'),
    silent port -> ('unknown', ...)). Not verified on hardware: the board was not
    enumerated.
    Python 0.1.11 -> 0.1.12. Committed on main at the maintainer's request.
2026-10-18 python: example_dsp.ipynb section 13, TX/RX on mux element 2 then element 4
    New section 13 after the pulser order check: set_one_mux(2) (0x000C), then
    set_one_mux(4) (0x00C0). For each it discards one raw capture, grabs raw and
    envelope into data/dsp_captures/mux_e<k>/, then clears the mux (in a finally)
    and plots both elements (data/mux_elements.png). Later sections are now 14-16;
    the section references in the board-test skill and .claude/TODO.md follow.
    Verified by running the new cell against a fake probe (mux replies, grab
    calls, figure saved). Not run on hardware: the board was not enumerated.
    Python 0.1.12 -> 0.1.13.
2026-10-18 repo: licenses per part (TAPR OHL 1.0, GPL-3.0-or-later, CC BY-SA 4.0)
    The maintainer's TAPR OHL text (untracked LICENSE.txt) moves to
    LICENSES/TAPR-OHL-1.0.txt and covers hardware/. Firmware and Python are
    GPL-3.0-or-later (LICENSES/GPL-3.0-or-later.txt, the gnu.org text, identical
    to /usr/share/common-licenses/GPL-3). Documentation is CC BY-SA 4.0
    (LICENSES/CC-BY-SA-4.0.txt, creativecommons.org legalcode). LICENSE.md maps
    each folder to its license and lists the third-party code
    (pico_sdk_import.cmake BSD-3-Clause; Pico SDK, TinyUSB, CMSIS-DSP fetched).
    No version bump: nothing under firmware/ or python/ changed.
2026-10-18 docs: user documentation in docs/, versioned, kept in step by a skill
    New docs/ (version 0.1.0, checked against firmware 0.1.15 and Python 0.1.13):
    introduction for newcomers, setup and first acquisitions, firmware overview
    (builds, acquisition, pulser, SPI/DAC/mux with the element table from the
    MUX netlist, DSP stages, 64-byte frame header, command reference, LED),
    Python library (Ultr4rick per build, mux helpers, dsp, ndt_acquisition,
    examples) and a repository map with the licenses.
    docs/version.yaml + docs/CHANGELOG.md use the same A.B.C scheme as firmware
    and Python. New skill ultr4rick-docs: every code change updates the pages it
    affects and bumps the docs patch. ultr4rick-versioning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
2026-10-18 repo: maintainer edits: copyright holder, TODO item, CONTRIBUTING.md
    LICENSE.md: copyright holder is kelu124. TODO.md: the back silkscreen has
    two TR4 labels. CONTRIBUTING.md added as written by the maintainer (pic0rick
    text, CC BY-SA 3.0 for docs; LICENSE.md says 4.0).
2026-10-18 docs: v0 board photos, image-description skill, SMA connection (docs 0.1.1)
    The maintainer's docs/images/v0 photos (front, back, running; full size and
    _small) are now described one paragraph each in docs/images/README.md and
    shown in the introduction, setup and firmware pages (small copy linked to
    the full one). New skill ultr4rick-docs-images: every image under
    docs/images/ gets a paragraph in docs/images/README.md in the same commit,
    plus naming, size and no-GPS checks.
    From the photos and the netlist: the PULSER_OUT (J1) and AFE_IN (J2) SMA
    edge connectors are documented as the simplest transducer connection (tee),
    and the v0 silkscreen labels U26-U29 TR4-TR7 instead of TR5-TR8 (firmwar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
2026-10-18 repo: README shows the board photos and two acquisition examples
    "The board": front, back and running photos (docs/images/v0, small copies
    linked to the full size) with short captions, and pointers to the KiCad
    renders. "Acquisition examples": python/data/mux_elements.png (the
    maintainer's e199deb run, elements 1-7, echo trains on 2 and 4) and
    python/data/pulsed_capture.png (idle vs pulsed, gain 50).
    No version bump (root README only).
2026-10-18 docs(claude): record the session's know-how in CLAUDE.md and skills
    CLAUDE.md: the LP5562 LED on I2C0 is driven (the old note said I2C was not);
    mux wiring and the SMA PULSER_OUT/AFE_IN bypass; v0 silkscreen TR4-TR7
    error; how the maintainer works (edits files mid-session, "commit all"
    includes them in a separate commit, mid-turn requests, open questions).
    ultr4rick-firmware: MAX14866 netlist mapping section, LED note, docs rule.
    ultr4rick-board-test: versions() in the standard check, the 2026-10-18 mux
    run (echoes on elements 2 and 4). .claude/TODO.md: hardware naming question.
2026-10-18 repo: CONTRIBUTING.md adapted to Ultr4rick, docs license CC BY-SA 4.0
    Maintainer's pic0rick text adapted: project name, GitHub links to
    kelu124/ultr4rick, RP2350B/Pico SDK instead of RP2040, VGA mentions dropped,
    folder pointers (hardware/, firmware/, python/, docs/), docs/images rule,
    versions() for bug reports. License section now links LICENSES/ and says
    CC BY-SA 4.0 International (maintainer's choice), matching LICENSE.md.
    Structure, the agent-PR note and the Matrix link are kept as written.
    No version bump.
2026-10-18 firmware: SPDX GPL-3.0-or-later headers, CHANGELOG reference fixed (0.1.16)
    Every firmware source, header, PIO program, CMake file, build.sh and
    version template starts with SPDX-License-Identifier: GPL-3.0-or-later
    (LICENSE.md). pico_sdk_import.cmake is left as is: it is the Pico SDK's
    BSD-3-Clause file. firmware/CHANGELOG.md pointed to docs/claude/README.md,
    which doesn't exist; it now points to the versioning skill.
    Verified: build.sh builds both variants with 0 warnings, picotool reports
    version 0.1.16. Comments only, so the code is unchanged. Not flashed: the
    board was not enumerated.
    Firmware 0.1.15 -> 0.1.16, docs 0.1.1 -> 0.1.2 (version references).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
2026-10-18 python: SPDX GPL-3.0-or-later headers, Readme documents the mux helpers (0.1.14)
    device.py, dsp.py, ndt_acquisition.py, __init__.py and example_dsp.py start
    with SPDX-License-Identifier: GPL-3.0-or-later. python/Readme.md now covers
    versions() and the version line printed at connection, write_mux() for any
    pattern, set_one_mux(k), mux_element_mask() with the element/switch rule, and
    a documentation and license section.
    Verified: the package and its modules import (ultr4rick.__version__ 0.1.14,
    module docstring intact), example_dsp.py compiles. Comments and docs only.
    Not run on hardware: the board was not enumerated.
    Python 0.1.13 -> 0.1.14, docs 0.1.2 -> 0.1.3 (version references).
    Co-Au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
